lryain/projects-dev/OLED_WATCH/图片/IMG_20150113_121012.jpg

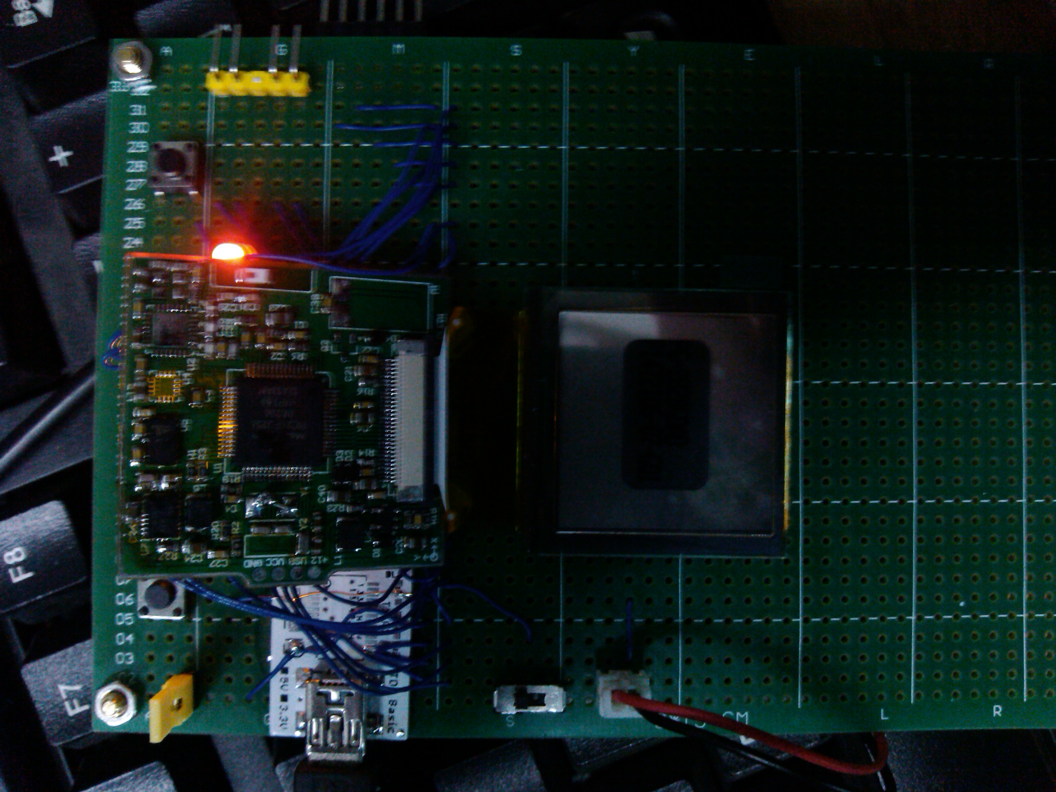
OLED_WATCH/图片/IMG_20150113_121012.jpg
