lryain/projects-dev/OLED_WATCH/图片/2111-reloj-open-source-3d-arm-oled-02.jpg

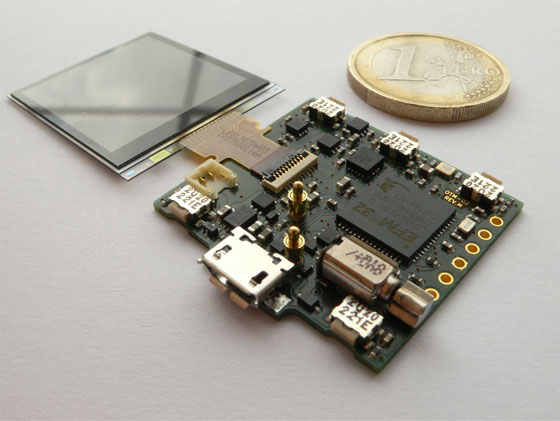
OLED_WATCH/图片/2111-reloj-open-source-3d-arm-oled-02.jpg
