lryain/projects-dev/OLED_WATCH/图片/IMG_20150113_120910.jpg

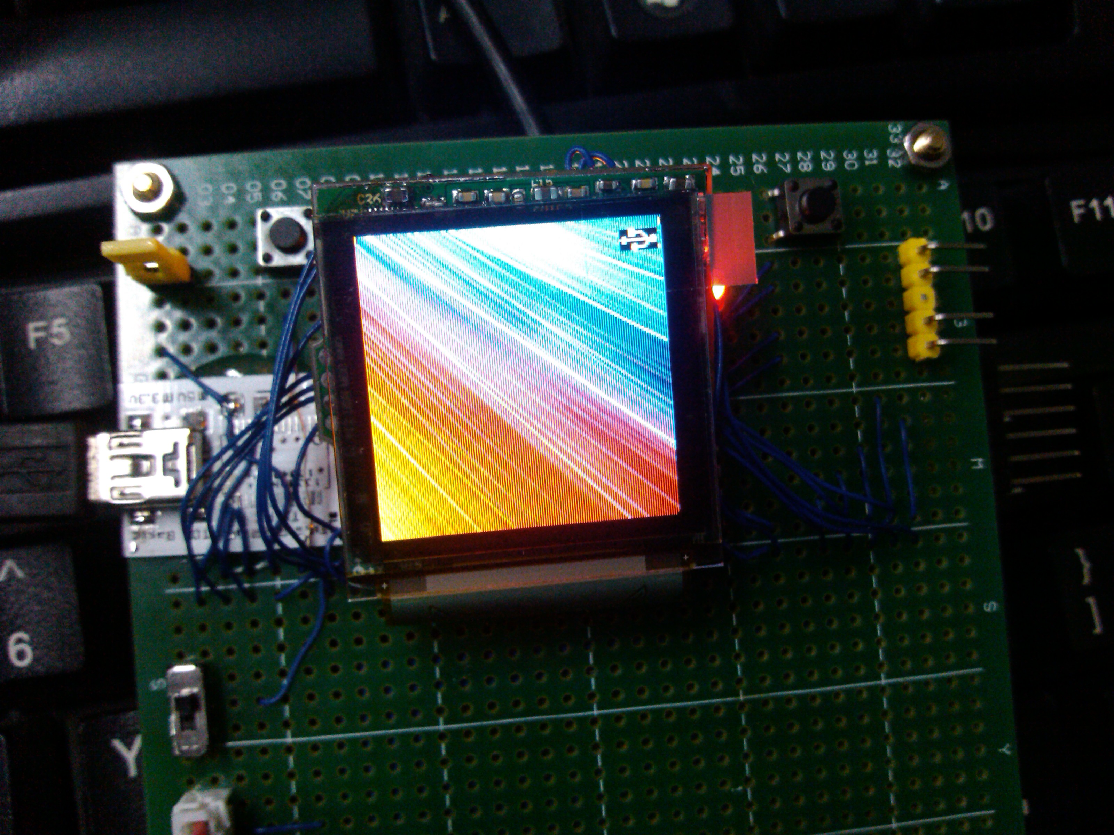
OLED_WATCH/图片/IMG_20150113_120910.jpg
