lryain/projects-dev/OLED_WATCH/图片/wydrukowany-zegarek-OTM-02-4.jpg

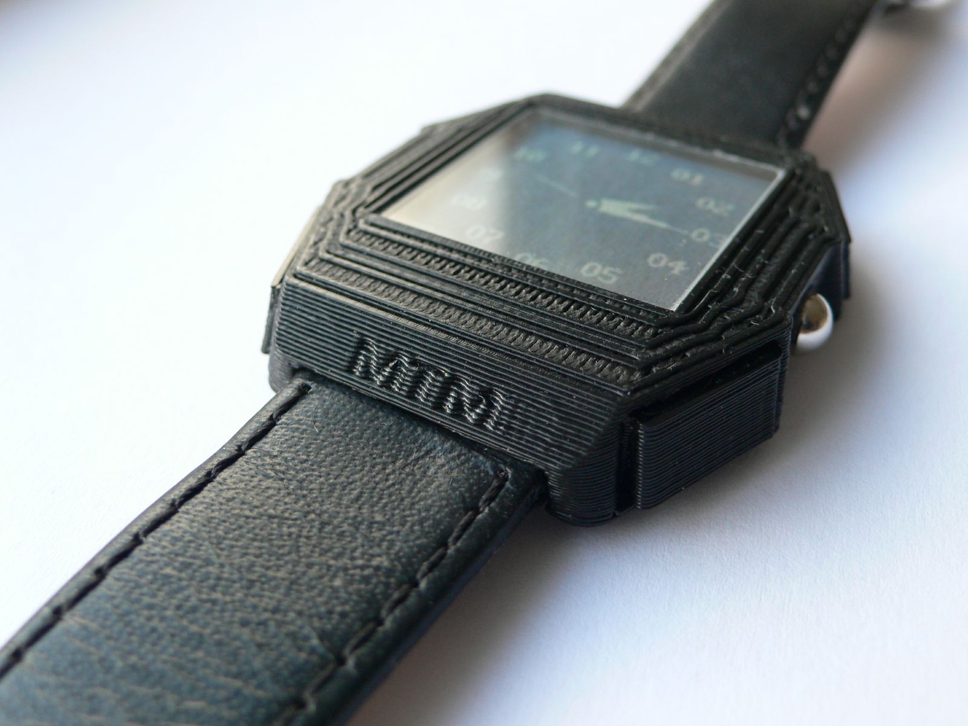
OLED_WATCH/图片/wydrukowany-zegarek-OTM-02-4.jpg
