lryain/projects-dev/OLED_WATCH/图片/下载.jpg

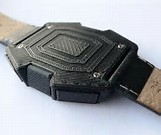
OLED_WATCH/图片/下载.jpg
