lryain/projects-dev/OLED_WATCH/PCB/OLED-Watch-BOM.xlsx

DocumentName | Comment | Description | Designator | Value | Footprint | Quantity | Manufacturer | Supplier 1 | Supplier Part Number 1 | Supplier Unit Price 1 | Notes
bluetoothle.SchDoc | 2.4GHz Chip Antenna | 2.4GHz Chip Antenna | ANT1 |  | 2450AT18A100E | 1 | JOHANSON TECHNOLOGY | Farnell | 1885496 | 2.18 | Optional, for bluetooth
cpu.SchDoc, cpu.SchDoc, cpu.SchDoc, cpu.SchDoc, cpu.SchDoc, cpu.SchDoc, cpu.SchDoc, cpu.SchDoc, cpu.SchDoc, sensors.SchDoc, sensors.SchDoc, sensors.SchDoc, sensors.SchDoc, oled.SchDoc, oled.SchDoc, oled.SchDoc, oled.SchDoc, sensors.SchDoc, power.SchDoc, bluetoothle.SchDoc, bluetoothle.SchDoc, cpu.SchDoc, bluetoothle.SchDoc, bluetoothle.SchDoc, bluetoothle.SchDoc, bluetoothle.SchDoc, power.SchDoc, power.SchDoc, cpu.SchDoc, bluetoothle.SchDoc, bluetoothle.SchDoc, bluetoothle.SchDoc | Cap | Capacitor | C1, C2, C3, C4, C5, C7, C8, C9, C10, C11, C12, C13, C14, C16, C18, C19, C22, C25, C27, C28, C29, C30, C31, C33, C34, C35, C36, C37, C38, C39, C41, C42 | 100nF, 100nF, 100nF, 100nF, 100nF, 18pF, 18pF, 7pF, 7pF, 100nF, 100nF, 100nF, 0.22uF, 220pF, 100nF, 1uF, 100nF, 100nF, 100nF, 1nF, 1.8pF, 100nF, 1.2pF, 100nF, 33nF, 2.2nF, 23pF, 106pF, 100nF, 4.7pF, 18pF, 18pF | 0603C | 32
cpu.SchDoc, oled.SchDoc, oled.SchDoc, cpu.SchDoc, power.SchDoc, power.SchDoc, bluetoothle.SchDoc, oled.SchDoc | Cap | Capacitor | C6, C20, C21, C23, C24, C26, C32, C40 | 10uF, 1uF, 1uF, 10uF, 10uF, 10uF, 1uF, 4.7uF | 0805C | 8 |  | Farnell | 1251125 | 0.33
sensors.SchDoc | Cap Pol1 | Polarized Capacitor | C15 | 4.7uF | 0805C | 1
oled.SchDoc | Tantalum | Polarized Capacitor | C17 | 4.7uF | 0805C | 1
oled.SchDoc | MBR0520 | Schottky Diode | D1 |  | 0603D | 1 |  | Farnell | 1467521 | 0.726
oled.SchDoc, oled.SchDoc, cpu.SchDoc | 1N4148 | Default Diode | D2, D3, D4 |  | 0603D | 3
power.SchDoc | MicroUSB |  | J1 |  | MICRO_USB | 1 |  |  | ???
oled.SchDoc, power.SchDoc | Inductor | Inductor | L1, L5 | 10uH | INDC3225N | 2 | TDK | Farnell | 1669925 | 0.673
bluetoothle.SchDoc | Inductor | Inductor | L2, L3, L4 | 3.9nH, 8.2nH, 5.6nH | 0603L | 3 |  | Farnell | Find these yourself! |  | Optional, for bluetooth
cpu.SchDoc | Green | Typical RED, GREEN, YELLOW, AMBER GaAs LED | LED1 |  | 0603LED | 1
cpu.SchDoc | Blue | Typical RED, GREEN, YELLOW, AMBER GaAs LED | LED2 |  | 0603LED | 1
cpu.SchDoc | Vibration Motor |  | M1 |  | VIBRATION_MOTOR | 1 |  |  |  |  | Custom component to match a motor out of an old phone.
oled.SchDoc | OLED Connector | 128x128 OLED Connector | OLED1 |  | FFC/SM0.5-2H30 | 1 |  | Farnell | 1816393 | 2.04 | Can get it cheaper through AliExpress, if you don't mind shipping wait time
oled.SchDoc | NL128128C OLED |  |  |  |  | 1 |  | Farnell | 1829707 | 44.84
sensors.SchDoc | Photo NPN | NPN Phototransistor | Q1 |  | TEMT6000 | 1 |  |  |  |  | Not using this in my final design
cpu.SchDoc | MOSFET-N | N-Channel MOSFET | Q2 |  | SOT-23B_N | 1 |  | Farnell | 1764535
cpu.SchDoc, cpu.SchDoc, cpu.SchDoc, cpu.SchDoc, sensors.SchDoc, cpu.SchDoc, cpu.SchDoc, cpu.SchDoc, cpu.SchDoc, cpu.SchDoc, cpu.SchDoc, cpu.SchDoc, oled.SchDoc, oled.SchDoc, oled.SchDoc, oled.SchDoc, power.SchDoc, power.SchDoc, power.SchDoc, cpu.SchDoc, bluetoothle.SchDoc, power.SchDoc, oled.SchDoc, power.SchDoc, power.SchDoc, power.SchDoc | Res3 | Resistor | R1, R2, R3, R4, R5, R6, R7, R8, R9, R10, R11, R12, R13, R14, R15, R16, R17, R18, R19, R20, R21, R22, R23, R24, R26, R27 | 100K, 100R, 100K, 10K, 10K, 470R, 100R, 100R, 100K, 100K, 100K, 100K, 118K, 50R, 13.3K, 560K, 680K, 121K, 1M, 100K, 22K, 1M, 1M, 1M, 0R, 10K | 0603R | 26 |  |  | See Misc
cpu.SchDoc | SideButton |  | S1, S2, S3, S4 |  | SIDE_BUTTON | 4 |  | Deal Extreme
cpu.SchDoc | PIC24FJ128GB206 | 16-bit Microcontroller | U1 |  | TQFP_64_10MM | 1 | Microchip | Farnell | 1823149 | 10.73 | Pin compatible with PIC24FJ256GB206
bluetoothle.SchDoc | nRF8001 | Bluetooth transceiver | U2 |  | QFN50P500X500-32V5N | 1 | Nordic Semiconductor | ??? |  |  | Optional, for bluetooth
sensors.SchDoc | HMC5883L | Honeywell 3 Axis Magnetometer | U4 |  | HMC5883L_16PINQFN | 1 | HONEYWELL M&PS | Farnell | 1971743 | 6.01
sensors.SchDoc | MMA7455LR1 | 3-Axis Accelerometer, 5g | U5 |  | LGA80P500X300-14N | 1 | FREESCALE SEMICONDUCTOR | Farnell | 1605506 | 4.22
oled.SchDoc | LM27313XMF | 1.6 MHz Boost Converter With 30V Internal FET Switch in SOT-23 | U6 |  | MF05A_N | 1 | National Semiconductor | Farnell | 1564771 | 1.35
power.SchDoc | BQ25010 | Buck converter & Li-Ion charger | U7 |  | RHL | 1 | Texas Instruments | Farnell | 1754763 | 7.08
cpu.SchDoc | 32MHz | Crystal Oscillator | Y1 |  | ABRACON32MHZ | 1 | ABRACON | Farnell | 1826821 | 1.99
cpu.SchDoc | 32.768kHz | Crystal Oscillator | Y2 |  | BCY-W2/D1.5 | 1 | Micro Crystal (http://www.mcrystal.ch/images/_PDF/2_Crystal_Metal-Package/MS3V-T1R_Pd.pdf) | Farnell | 1539368 | 0.847 | Same crystal as used in the MSP430 Launchpad
bluetoothle.SchDoc | TXC-16MHz |  | Y3 | 16MHz | TXC-16MHZ | 1 |  | Farnell | 2308720 | 3.23 | Optional, for bluetooth
IMPORTANT: BOM is not guaranteed to be 100% correct! Double check everything against the PCB AND Schematic before ordering!!
 |  | Misc Components
 |  | Resistor |  | 13K3 1% |  |  |  | Farnell | 1170899 | 0.011
 |  | Resistor |  | 118K 1% |  |  |  | Farnell | 1170992 | 0.011
 |  | Resistor |  | 169K 1% |  |  |  | Farnell | 1171007 | 0.011
 |  | Resistor |  | 680K 1% |  |  |  | Farnell | 9238824 | 0.011
 |  | Resistor |  | 1Mohm |  | 100 |  | Farnell | 2073358 | 0.003
 |  | Capacitor |  | 1uF 10V 0805 |  | 10 |  | Farnell | 1683677 | 0.057
 |  | Capacitor |  | 100nF 0603 |  | 100 |  | Farnell | 1833863 | 0.022
 |  | Capacitor |  | 10uF 0805 |  | 10 |  | Farnell | 1833812 | 0.11
 |  | ChipQuick Flux |  |  |  | 1 |  | Farnell | 1850216 | 28.33 | NOTE: Very useful!
 |  | Approximate Costs
 |  | Discretes | $17.98
 |  | OLED | $44 | (or cheaper from china)
 |  | Semiconductors | $46.70
 |  | Total: | $108.68
