lryain/projects-dev/OLED_WATCH/PCB/OLED-Watch-BOM2.xlsx

Sheet: OLED
Designator | Value | Footprint | Quantity | Description | Manufacturer | DocumentName | Supplier 1 | Supplier Part Number 1 | Supplier Unit Price 1 | Notes
ANT1 | 2450AT18A100E |  | 1 | ANTENNA, CERAMIC, 2.45GHZ'2.4GHz Chip Antenna | JOHANSON TECHNOLOGY | bluetoothle.SchDoc | Farnell | 1885496 | 2.18 | http://detail.tmall.com/item.htm?id=41528976881&ad_id=&am_id=&cm_id=140105335569ed55e27b&pm_id=&abbucket=10
D1 | MBR0520 | 0603D | 1 | Schottky Diode |  | oled.SchDoc | Farnell | 1467521 | 0.726
D2, D3, D4 | 1N4148 | 0603D | 3 | Default Diode |  | oled.SchDoc, oled.SchDoc, cpu.SchDoc
J1 |  |  | 1 | MicroUSB |  | power.SchDoc |  | ???
L1, L5 | 10uH | INDC3225N | 2 | TDK NLV32T-100J-PF INDUCTOR, SIGNAL LINE, 10UH, 1210 | TDK | oled.SchDoc, power.SchDoc | Farnell | 1669925 | 0.673 | http://item.taobao.com/item.htm?id=39839665898&ns=1&abbucket=10&_u=61s0mh8bfe5
L2, L3, L4 | 3.9nH, 8.2nH, 5.6nH | 0603L | 3 | Inductor |  | bluetoothle.SchDoc | Farnell | Find these yourself! |  | http://detail.tmall.com/item.htm?spm=a1z0d.6639537.1997196601.106.aQh0eo&id=25090276562
M1 |  | VIBRATION_MOTOR | 1 | Vibration Motor |  | cpu.SchDoc |  |  |  | Custom component to match a motor out of an old phone.
~~OLED1~~ | ~~FFC/SM0.5-2H30~~ | ~~FFC/SM0.5-2H30~~ | ~~1~~ | ~~128x128 OLED Connector TE CONNECTIVITY / AMP 3-1734592-0 CONNECTOR, FFC / FPC, 0.5MM, 30WAY~~ |  | ~~oled.SchDoc~~ | ~~Farnell~~ | ~~1816393~~ | ~~2.04~~ | ~~Can get it cheaper through AliExpress, if you don't mind shipping wait time~~
 | NL128128C OLED |  | 1 | NL128128C OLED |  | oled.SchDoc | Farnell | 1829707 | 44.84 | http://cart.taobao.com/add_cart_succeed.htm?_input_charset=GBK
Q1 | TEMT6000 |  | 1 | NPN Phototransistor |  | sensors.SchDoc |  |  |  | Not using this in my final design
Q2 | 2N7002KT1G | SOT-23B_N | 1 | ON SEMICONDUCTOR 2N7002KT1G. N CHANNEL MOSFET, 60V, 380mA SOT-23 |  | cpu.SchDoc | Farnell | 1764535
S1, S2, S3, S4 |  | SIDE_BUTTON | 4 | SideButton |  | cpu.SchDoc
U1 | PIC24FJ128GB206 | TQFP_64_10MM | 1 | 16-bit Microcontroller | Microchip | cpu.SchDoc | Farnell | 1823149 | 10.73 | Pin compatible with PIC24FJ256GB206
U2 | nRF8001 | QFN50P500X500-32V5N | 1 | Bluetooth transceiver | Nordic Semiconductor | bluetoothle.SchDoc | ??? |  |  | http://item.taobao.com/item.htm?id=22614959764&ns=1&abbucket=10&_u=61s0mh842f2
U4 | HMC5883L | HMC5883L_16PINQFN | 1 | Honeywell 3 Axis Magnetometer | HONEYWELL M&PS | sensors.SchDoc | Farnell | 1971743 | 6.01
U5 | MMA7455LR1 | LGA80P500X300-14N | 1 | 3-Axis Accelerometer, 5g | FREESCALE SEMICONDUCTOR | sensors.SchDoc | Farnell | 1605506 | 4.22 | http://item.taobao.com/item.htm?id=12379344259&asker=wangwang&wwdialog=bbxxbbmc&ad_id=&am_id=&cm_id=&pm_id=
U6 | LM27313XMF | SOT-23 | 1 | 1.6 MHz Boost Converter With 30V Internal FET Switch | National Semiconductor | oled.SchDoc | Farnell | 1564771 | 1.35 | http://detail.tmall.com/item.htm?id=38890542720&ad_id=&am_id=&cm_id=140105335569ed55e27b&pm_id=&abbucket=10
U7 | BQ25010/11/12 | RHL | 1 | Buck converter & Li-Ion charger | Texas Instruments | power.SchDoc | Farnell | 1754763 | 7.08 | http://detail.tmall.com/item.htm?spm=a230r.1.14.4.6hXpe0&id=35507429341&abbucket=10&_u=61s0mh83164
Y1 | 32MHz | ABRACON32MHZ | 1 | Crystal Oscillator | ABRACON | cpu.SchDoc | Farnell | 1826821 | 1.99
Y2 | 32.768kHz | BCY-W2/D1.5 | 1 | MICRO CRYSTAL MS3V-T1R 32.768KHZ +-20PPM 12.5PF CRYSTAL, SMD MET 32.768KHZ 12.5 | Micro Crystal (http://www.mcrystal.ch/images/_PDF/2_Crystal_Metal-Package/MS3V-T1R_Pd.pdf) | cpu.SchDoc | Farnell | 1539368 | 0.847 | http://item.taobao.com/item.htm?id=38330729752&ns=1&abbucket=10&_u=61s0mh803fb
Y3 | TXC-16MHz | TXC-16MHZ | 1 | TXC 7M-16.000MEEQ-T QUARTZ CRYSTAL, 16 MHZ, 10 PF, SMD |  | bluetoothle.SchDoc | Farnell | 2308720 | 3.23 | Optional, for bluetooth

Sheet: Sheet1
 |  | IMPORTANT: BOM is not guaranteed to be 100% correct! Double check everything against the PCB AND Schematic before ordering!!
 | Misc Components
 | Resistor |  |  | 13K3 1%
 | Resistor |  |  | 118K 1%
 | Resistor |  |  | 169K 1%
 | Resistor |  |  | 680K 1%
 | Resistor |  |  | 1Mohm | 100
 | Capacitor |  |  | 100nF 0603 | 100
 | Capacitor |  |  | 10uF 0805 | 10
 | Capacitor |  |  | 1uF 10V 0805 | 10
 | Capacitor |  |  | 4.7uF 0805 | 10
100nF, 100nF, 100nF, 100nF, 100nF, 18pF, 18pF, 7pF, 7pF, 100nF, 100nF, 100nF, 0.22uF, 220pF, 100nF, 1uF, 100nF, 100nF, 100nF, 1nF, 1.8pF, 100nF, 1.2pF, 100nF, 33nF, 2.2nF, 23pF, 106pF, 100nF, 4.7pF, 18pF, 18pF | 0603C | C1, C2, C3, C4, C5, C7, C8, C9, C10, C11, C12, C13, C14, C16, C18, C19, C22, C25, C27, C28, C29, C30, C31, C33, C34, C35, C36, C37, C38, C39, C41, C42 | 32 | Capacitor | cpu.SchDoc, cpu.SchDoc, cpu.SchDoc, cpu.SchDoc, cpu.SchDoc, cpu.SchDoc, cpu.SchDoc, cpu.SchDoc, cpu.SchDoc, sensors.SchDoc, sensors.SchDoc, sensors.SchDoc, sensors.SchDoc, oled.SchDoc, oled.SchDoc, oled.SchDoc, oled.SchDoc, sensors.SchDoc, power.SchDoc, bluetoothle.SchDoc, bluetoothle.SchDoc, cpu.SchDoc, bluetoothle.SchDoc, bluetoothle.SchDoc, bluetoothle.SchDoc, bluetoothle.SchDoc, power.SchDoc, power.SchDoc, cpu.SchDoc, bluetoothle.SchDoc, bluetoothle.SchDoc, bluetoothle.SchDoc
10uF, 1uF, 1uF, 10uF, 10uF, 10uF, 1uF, 4.7uF | 0805C | C6, C20, C21, C23, C24, C26, C32, C40 | 8 | Capacitor | cpu.SchDoc, oled.SchDoc, oled.SchDoc, cpu.SchDoc, power.SchDoc, power.SchDoc, bluetoothle.SchDoc, oled.SchDoc | Farnell | 1251125 | 0.33
4.7uF | 0805C | C15 C17 | 2 | Polarized Capacitor | sensors.SchDoc
 | 0603LED | LED1 | 1 | Green | cpu.SchDoc
 | 0603LED | LED2 | 1 | Blue | cpu.SchDoc
100K, 100R, 100K, 10K, 10K, 470R, 100R, 100R, 100K, 100K, 100K, 100K, 118K, 50R, 13.3K, 560K, 680K, 121K, 1M, 100K, 22K, 1M, 1M, 1M, 0R, 10K | 0603R | R1, R2, R3, R4, R5, R6, R7, R8, R9, R10, R11, R12, R13, R14, R15, R16, R17, R18, R19, R20, R21, R22, R23, R24, R26, R27 | 26 | Resistor | cpu.SchDoc, cpu.SchDoc, cpu.SchDoc, cpu.SchDoc, sensors.SchDoc, cpu.SchDoc, cpu.SchDoc, cpu.SchDoc, cpu.SchDoc, cpu.SchDoc, cpu.SchDoc, cpu.SchDoc, oled.SchDoc, oled.SchDoc, oled.SchDoc, oled.SchDoc, power.SchDoc, power.SchDoc, power.SchDoc, cpu.SchDoc, bluetoothle.SchDoc, power.SchDoc, oled.SchDoc, power.SchDoc, power.SchDoc, power.SchDoc |  | See Misc
7pF/8pF代替
18pF
220nF
220pF
1uF
1nF
1.8pF
1.2pF/1.5pF代替
33nF
2.2nF
23pF/22pF代替
106pF/100pF代替
4.7pF
470R
100R
47R/49.9
50R/49.9
0R
10K
13.3K/13.7K
22K
100K
121K/120k
118K
169K/150K
560K
680K
1M
