lryain/projects-dev/OLED_WATCH/文档/硬件调试.docx

## Regulator Problems

Initially the regulator wouldn't work, it'd produce a very unstable voltage somewhere between 2-4V, so I probed it with an oscilloscope and noticed it was oscillating heavily! Luckily the fix for this was to add a single 100nF capacitor across the battery connection.

Decoupling capacitors are important!!

加了之后可以正常进入app mode
