lryain/projects-dev/OLED_WATCH/PCB/OLED-Watch-PCB.pdf

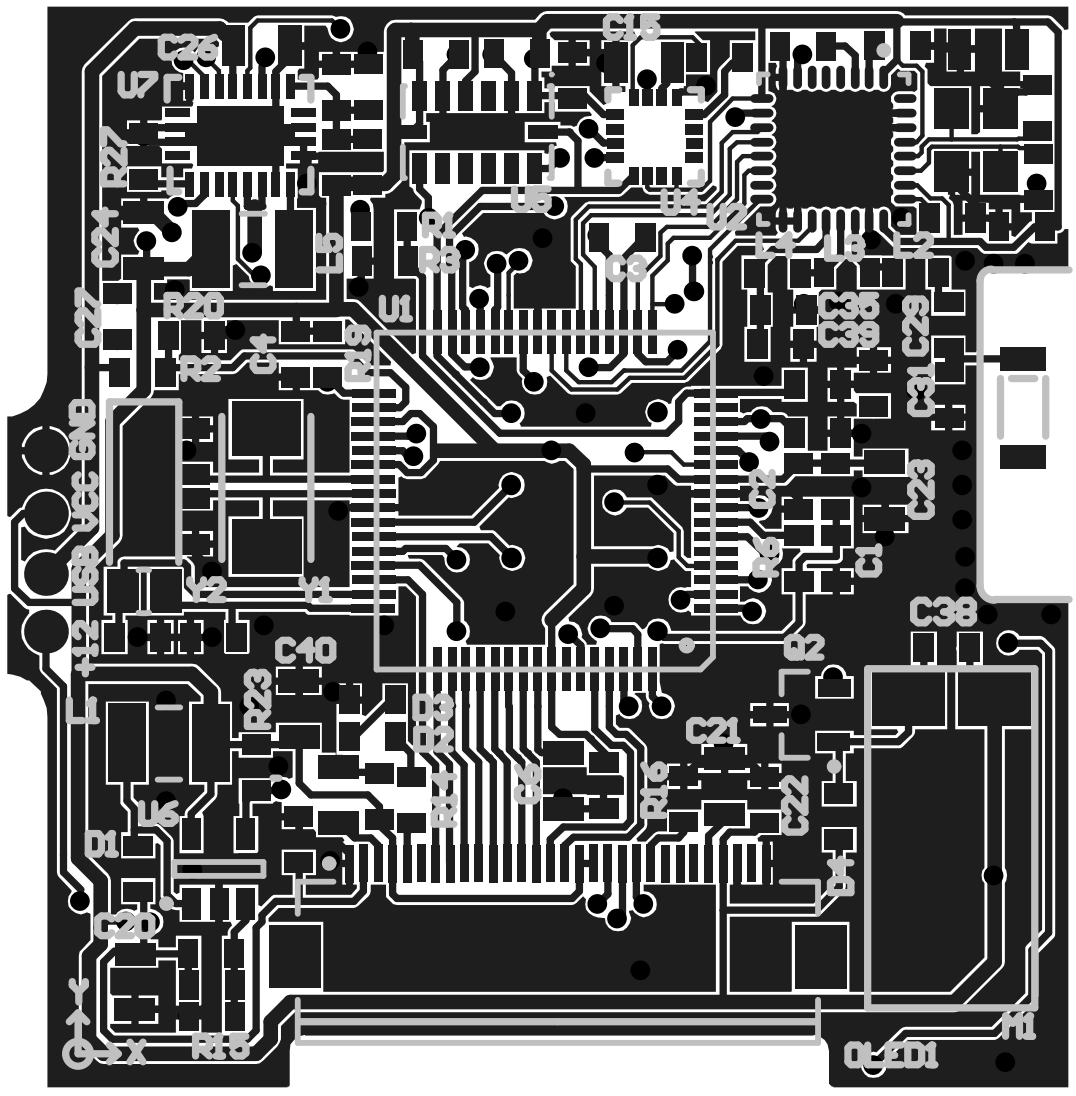
[picture p30: page 1]

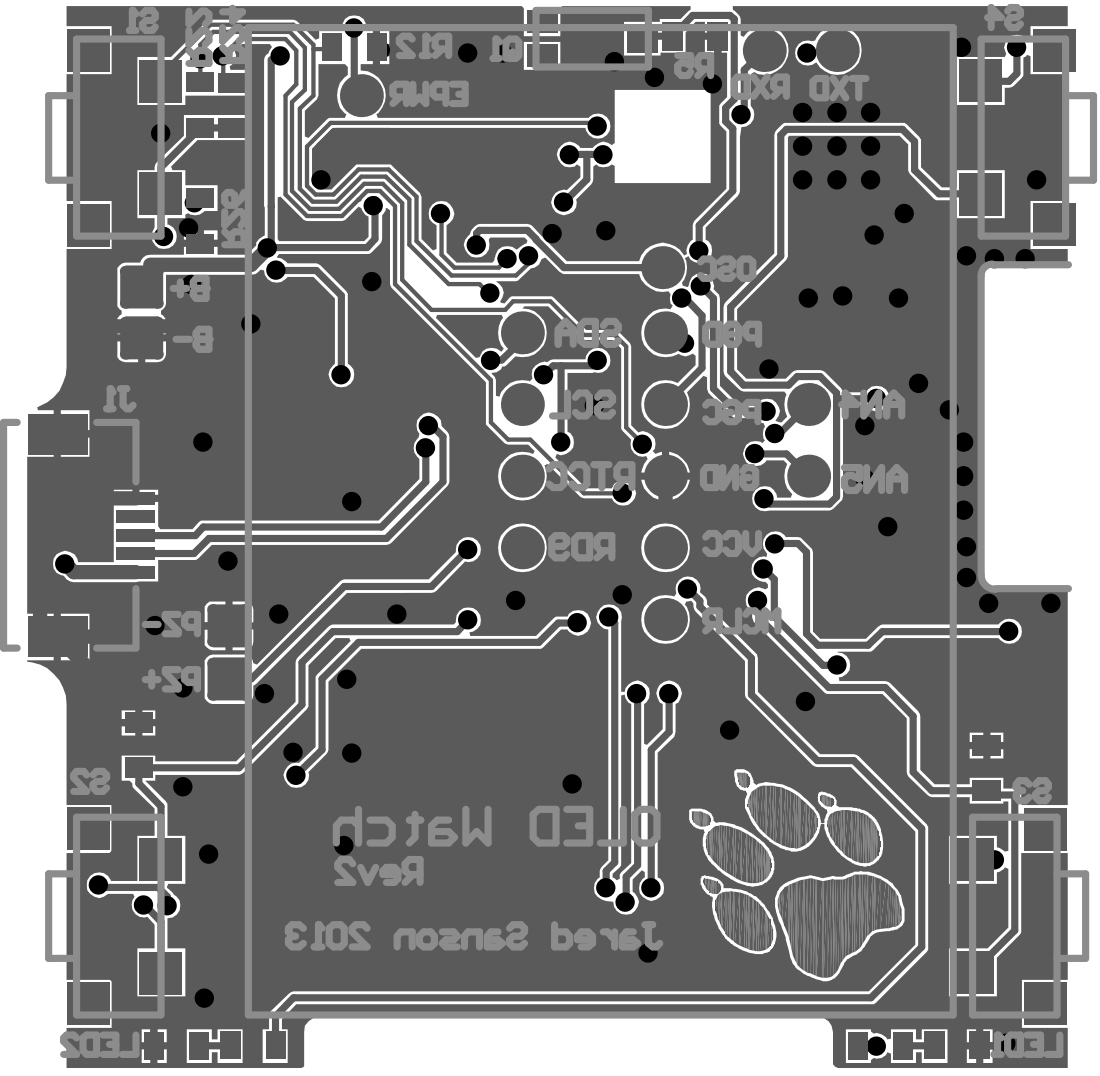
[picture p31: page 2]
