lryain/projects-dev/(list of files, drawings)

Other design files:
OLED_WATCH/PCB/PCB-OLED-Watch-Rev2-Altium/bluetoothle.SchDoc
OLED_WATCH/PCB/PCB-OLED-Watch-Rev2-Altium/cpu.SchDoc
OLED_WATCH/PCB/PCB-OLED-Watch-Rev2-Altium/OLED.PrjPcb
OLED_WATCH/PCB/PCB-OLED-Watch-Rev2-Altium/oled.SchDoc
OLED_WATCH/PCB/PCB-OLED-Watch-Rev2-Altium/pcb.PcbDoc
OLED_WATCH/PCB/PCB-OLED-Watch-Rev2-Altium/power.SchDoc
OLED_WATCH/PCB/PCB-OLED-Watch-Rev2-Altium/sensors.SchDoc
